mihaigalos/DotShine/hardware/DotShine.brd

## EAGLE design hardware/DotShine.brd (2019-03-06)

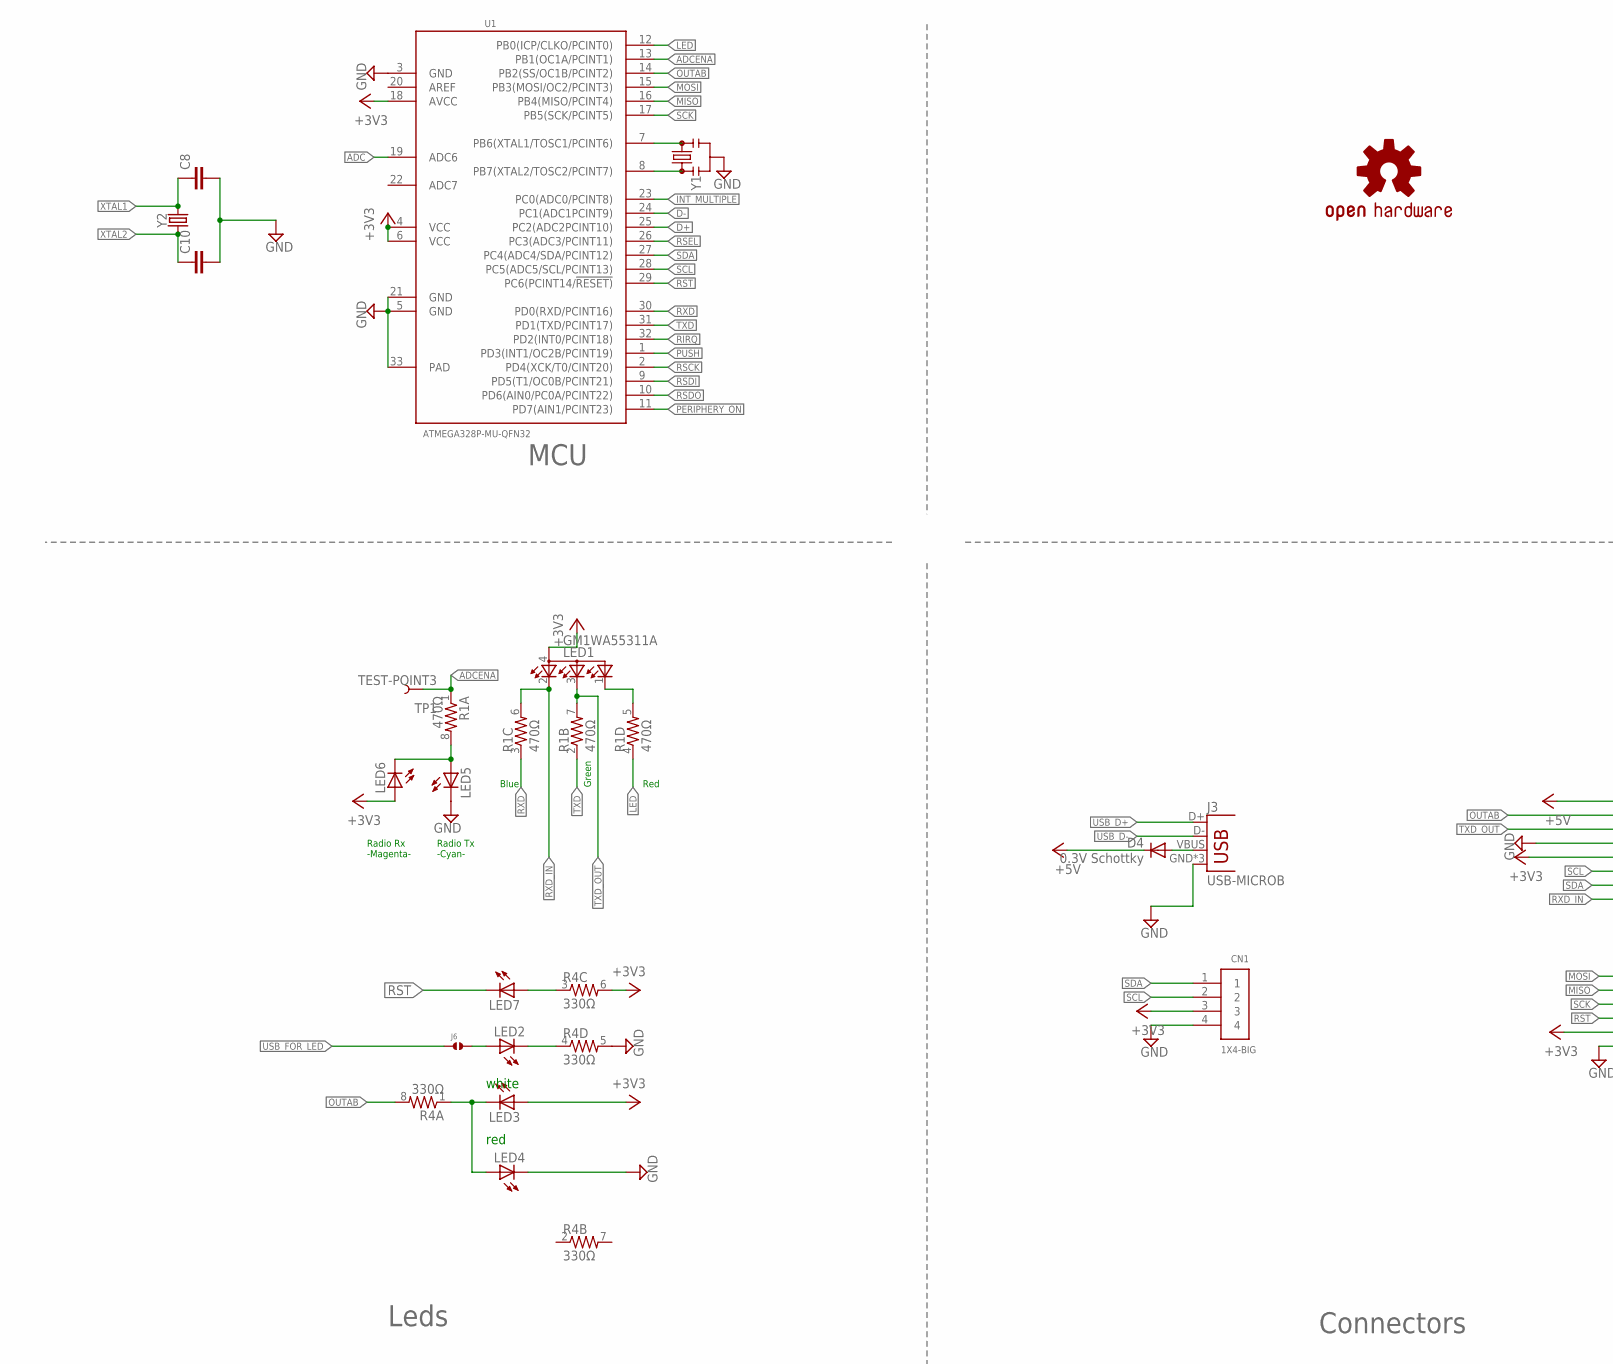
[picture p1: schematic DotShine.sch, part in row 1, column 1]

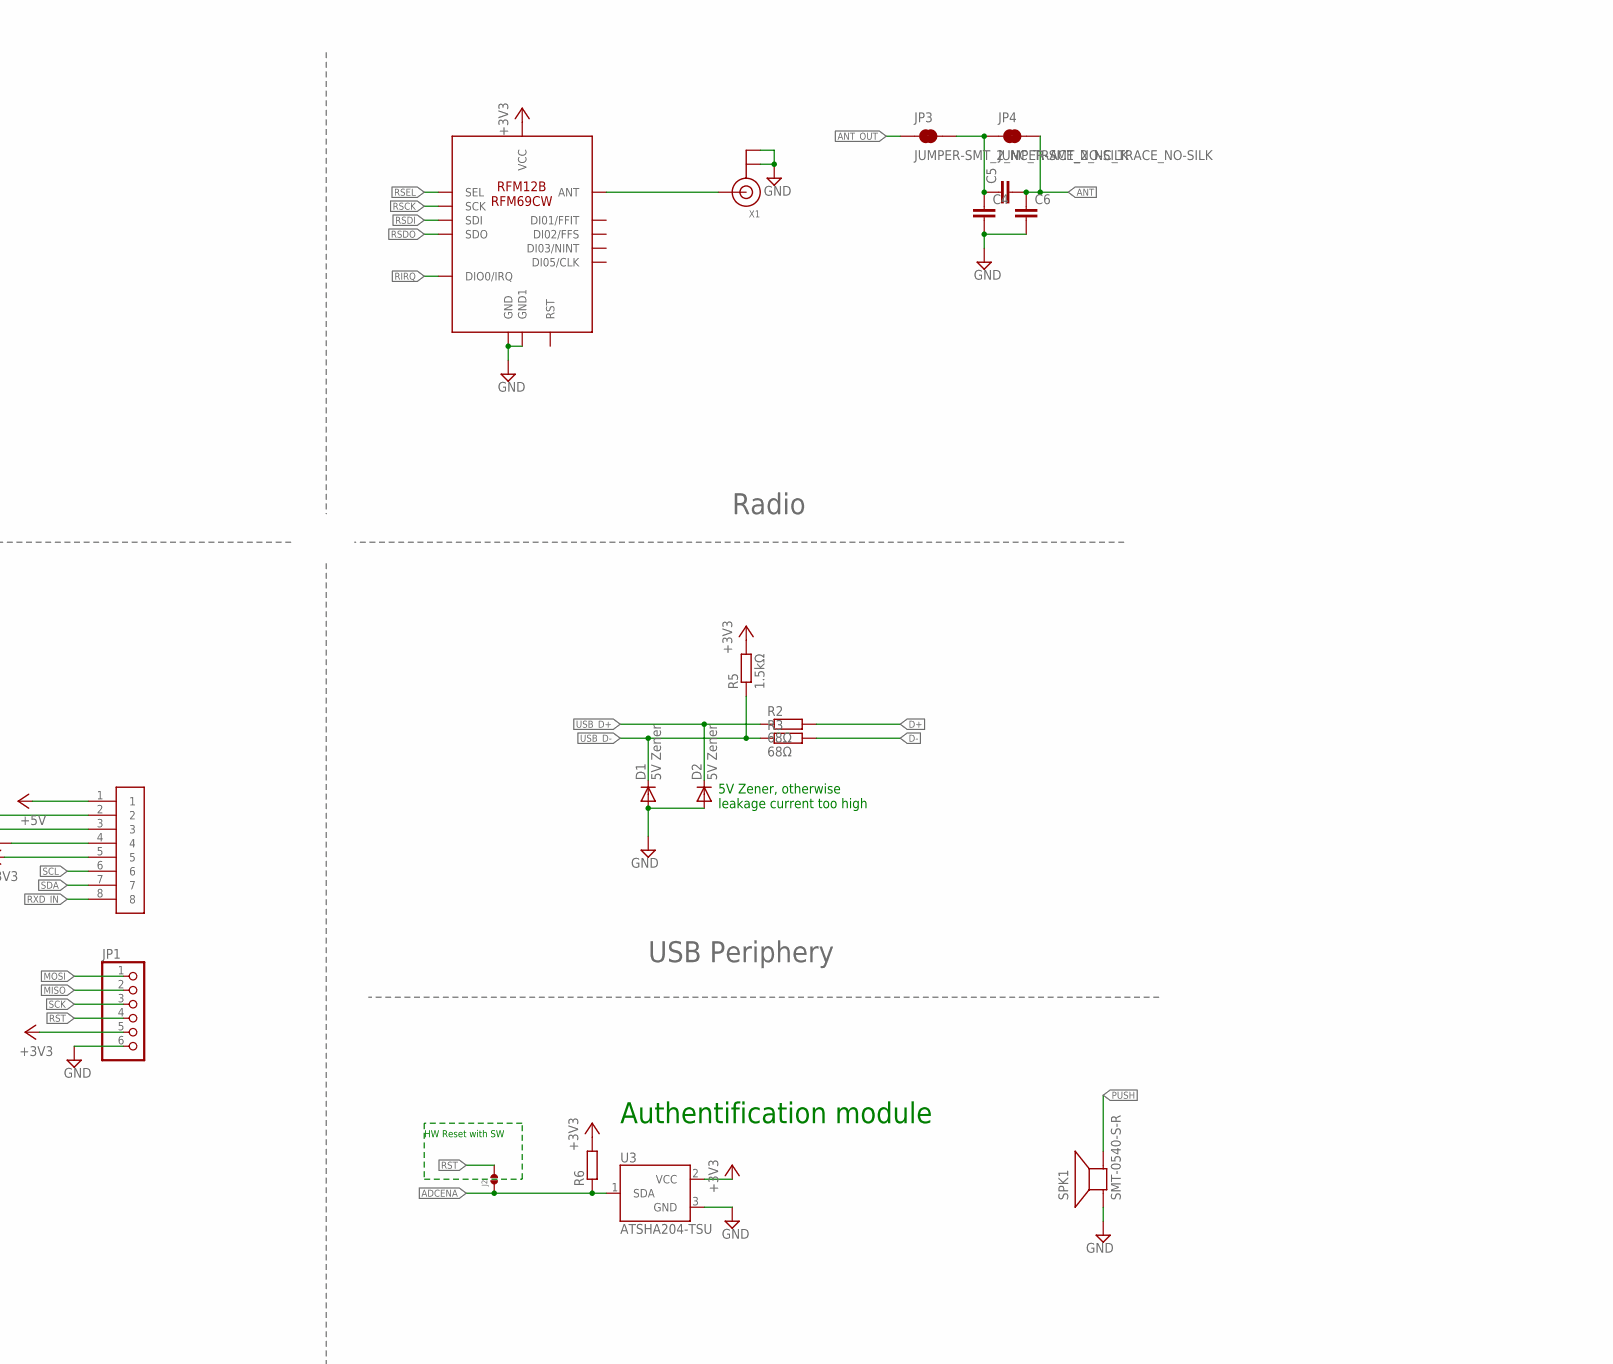
[picture p2: schematic DotShine.sch, part in row 1, column 2]

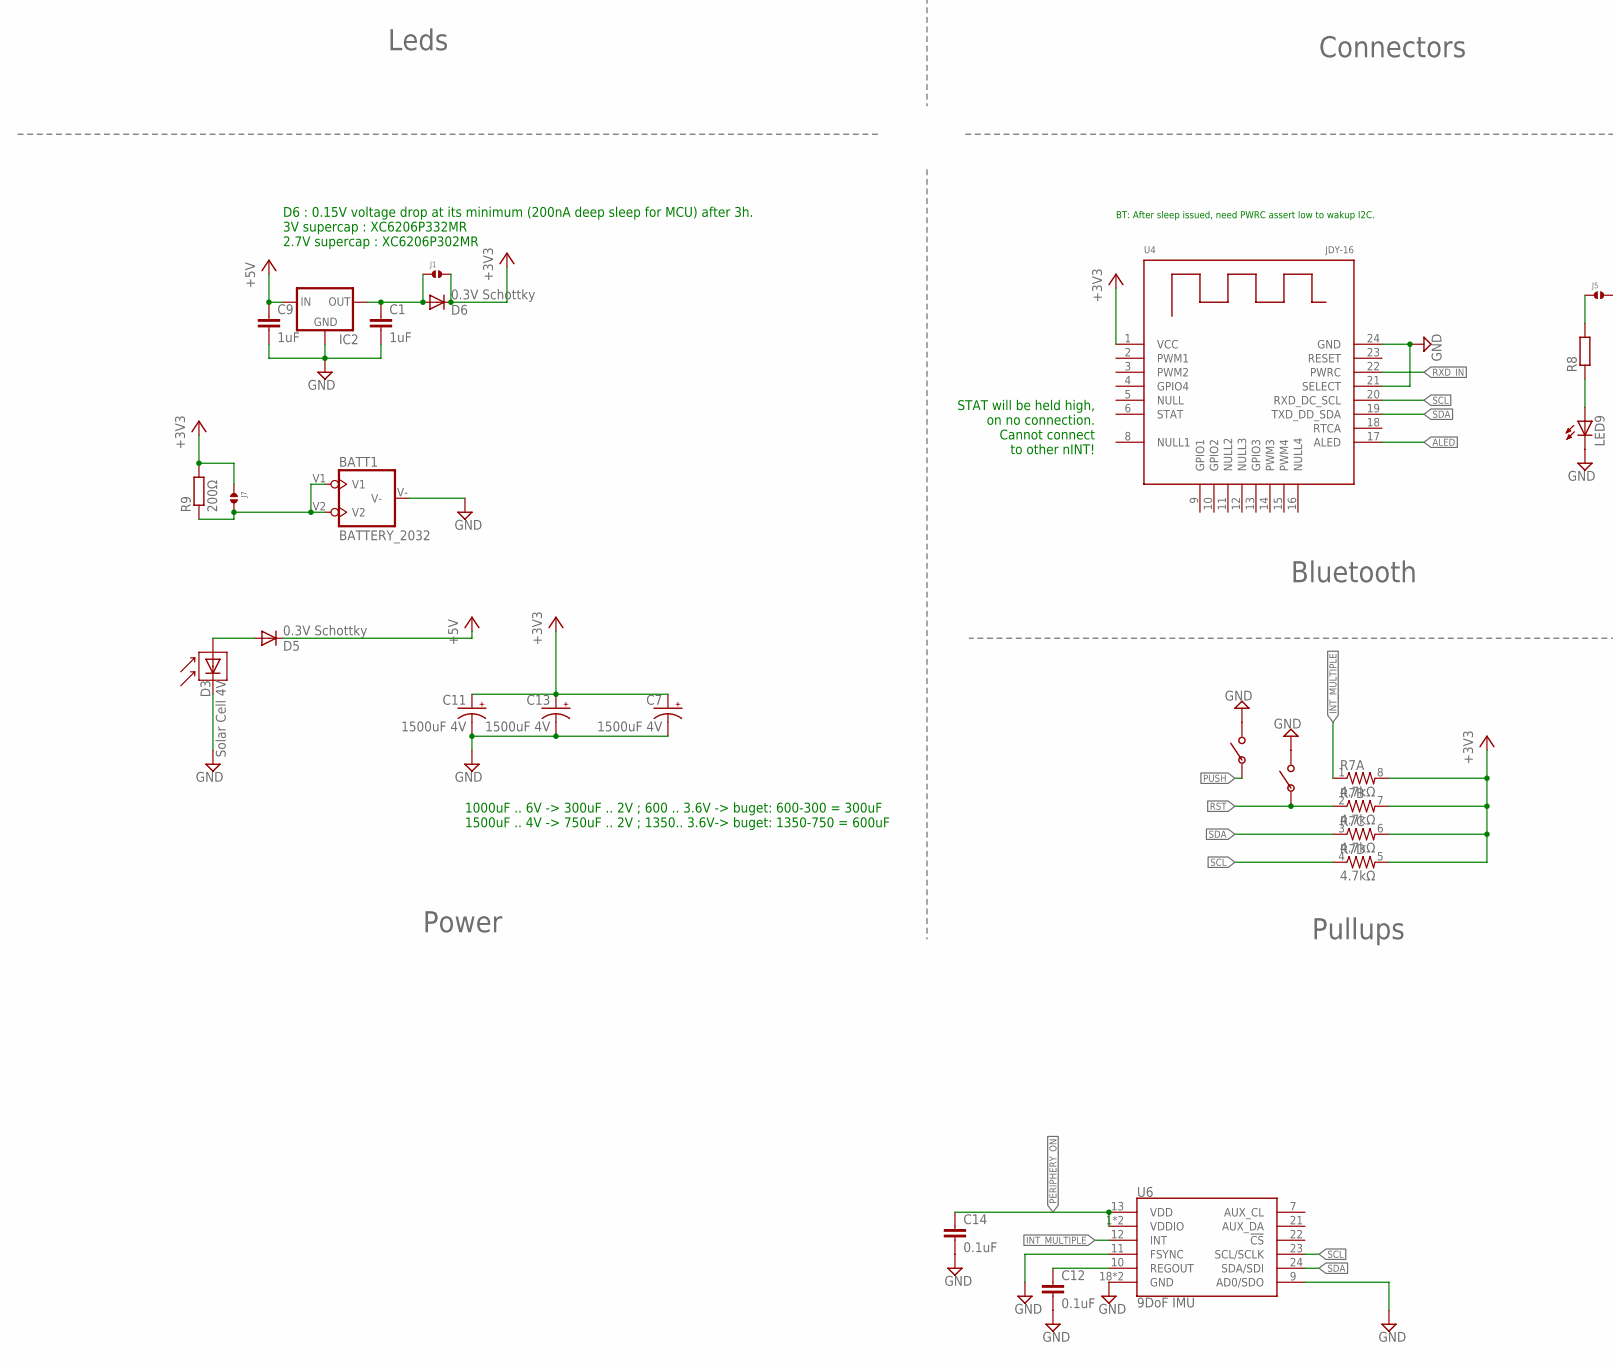
[picture p3: schematic DotShine.sch, part in row 2, column 1]

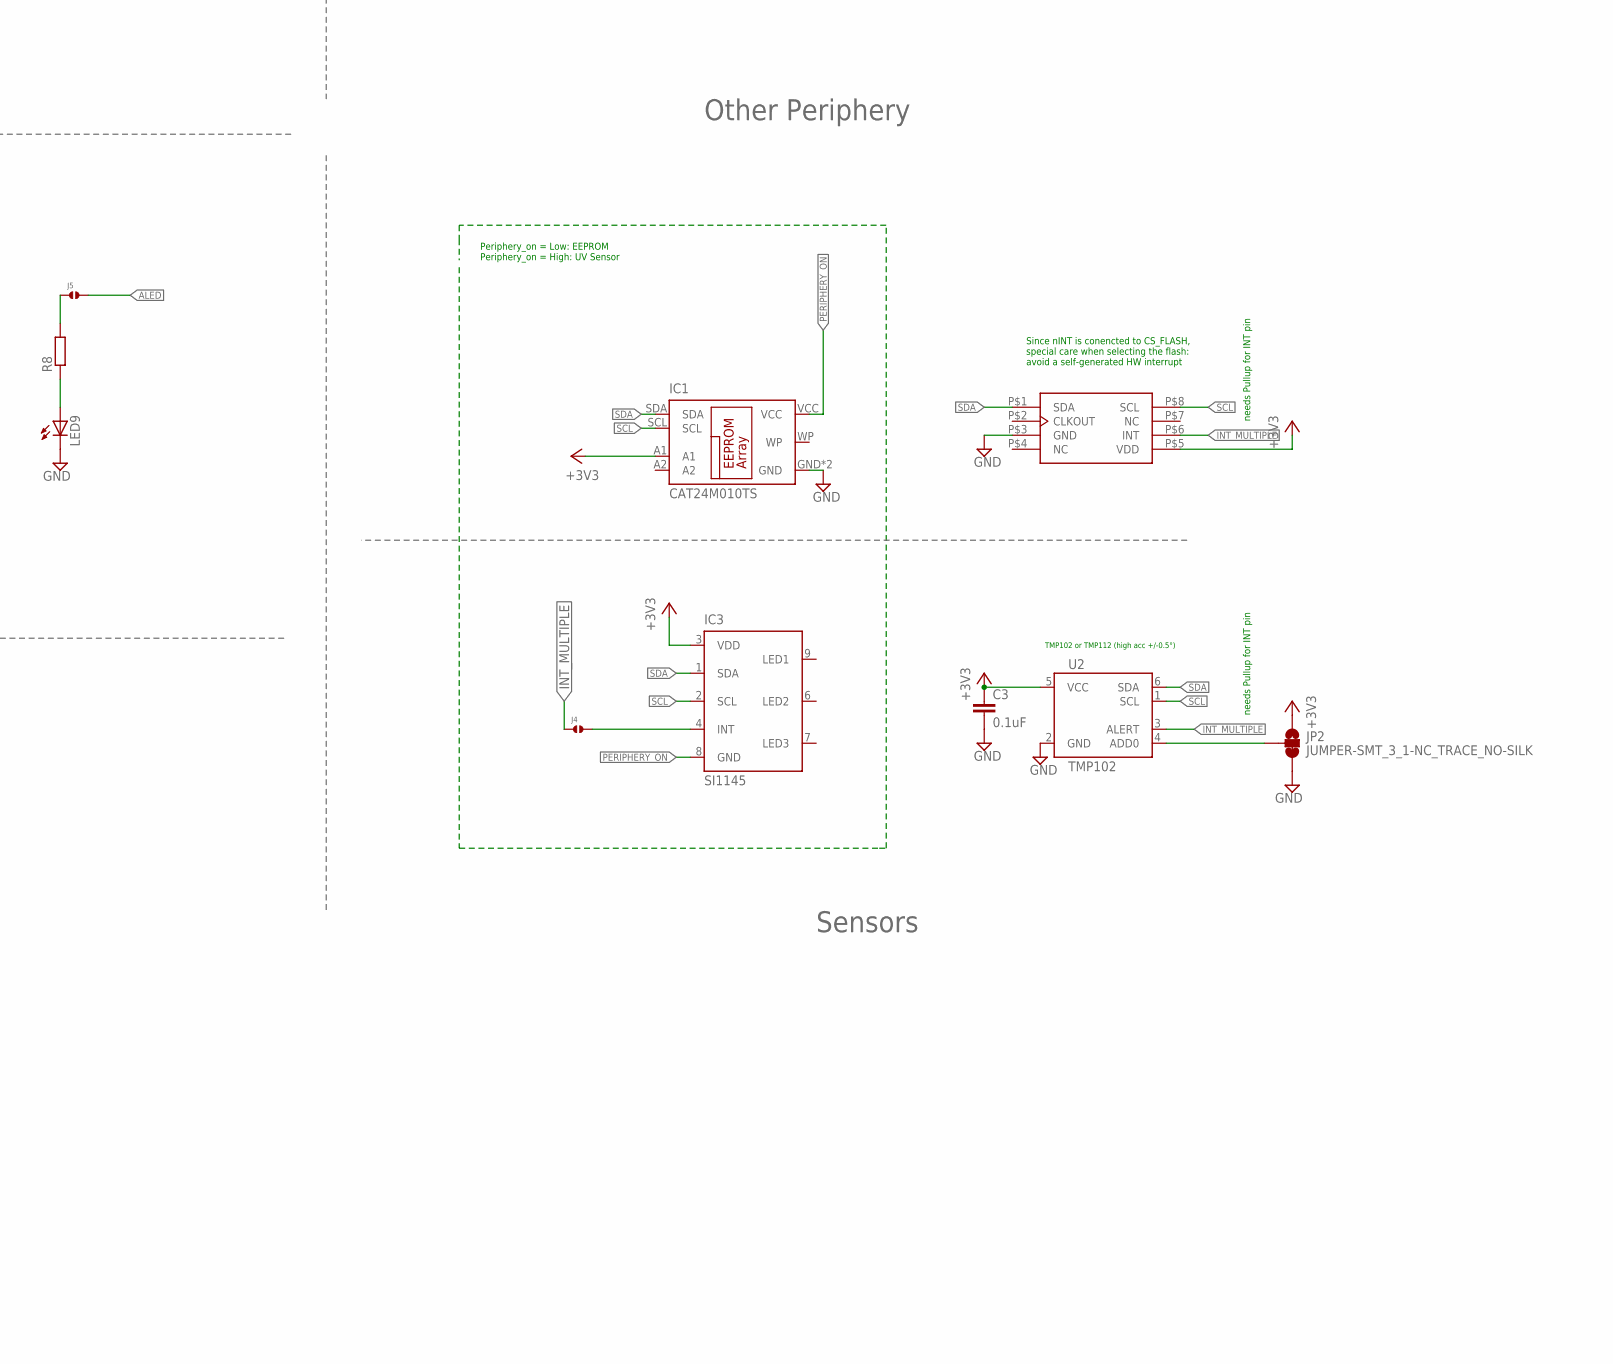
[picture p4: schematic DotShine.sch, part in row 2, column 2]

Parts:
BATT1: BATTERY_2032; BATT2032
C1, C9: 1uF; C0603
C3, C12, C14: 0.1uF; C0603
C4, C5, C6: C-EUC0603; C0603
C7, C11, C13: 1500uF 4V; CT7343
C8, C10: C-EUC0402; C0402
CN1: 1X4-BIG; 1X04-BIG
D1, D2: 5V Zener; SOD523
D3: Solar Cell 4V; SOLARBIT-12X1
D4, D5, D6: 0.3V Schottky; SOD523
IC1: CAT24M010TS; TSSOP8
IC2: MCP1700TT; SOT-23
IC3: SI1145; QFN-10
J1, J2, J4, J5, J6, J7: SOLDERJUMPER.2.MED; 2.MED
J3: USB-MICROB
JP1: PINHD-1X6; 1X06
JP2: JUMPER-SMT_3_1-NC_TRACE_NO-SILK; SMT-JUMPER_3_1-NC_TRACE_NO-SILK
JP3, JP4: JUMPER-SMT_2_NC_TRACE_NO-SILK; SMT-JUMPER_2_NC_TRACE_NO-SILK
LED1: GM1WA55311A
LED2, LED3, LED4, LED5, LED6, LED7, LED9: LED0603; LED-0603
LOGO1: OSHW-LOGOS; OSHW-LOGO-S
R1: 470Ω; 0603-ARV
R2, R3: 68Ω; R0603
R4: 330Ω; 0603-ARV
R5: 1.5kΩ; R0603
R6, R8: R-EU_R0603; R0603
R7: 4.7kΩ; 0603-ARV
R9: 200Ω; R0603
SPK1: SMT-0540-S-R
TP1: TEST-POINT3; PAD.03X.03
U1: ATMEGA328P-MU-QFN32; QFN32G-0.5-5X5MM
U2: TMP102; SOT563
U3: ATSHA204-TSU; SOT23-3
U4: JDY-16
U6: 9DoF IMU; QFN24-3X3
U$1: RFM12B/69CW
U$2, U$3: PUSHBUTTON_4X2.5
U$4: JST-8; S4B-ZR
X1: ANTENNA_U.FL; U.FL
X2: MC-RTC-RV-4162-C7-I2C; MC-RTC-C7
Y1: RESONATORSMD-3.2X1.3; RESONATOR-SMD-3.2X1.3
Y2: CRYSTALSMD-3.2X1.5; CRYSTAL-SMD-3.2X1.5MM

Connections:
+3V3: C3.1, C7.+, C11.+, C13.+, CN1.3, D6.C, IC1.A1, IC3.3 (VDD), J1.2, J7.1, JP1.5, JP2.1, LED1.4 (A), LED3.A, LED6.A, R4.6 (2), R5.2, R6.2, R7.5 (2), R7.6 (2), R7.7 (2), R7.8 (2), R9.2, U1.4 (VCC), U1.6 (VCC), U1.18 (AVCC), U2.5 (VCC), U3.2 (VCC), U4.1 (VCC), U$1.VDD (VCC), U$4.5, X2.P$5 (VDD)
+5V: C9.1, D4.C, D5.C, IC2.3 (IN), U$4.1
ADC: U1.19 (ADC6)
ADCENA: J2.1, R1.1, R6.1, TP1.P$1, U1.13 (PB1(OC1A/PCINT1)), U3.1 (SDA)
ALED: J5.2, U4.17 (ALED)
ANT: C5.2, C6.1, JP4.2
ANT_OUT: JP3.1, U$1.ANT, X1.3 (SIGNAL)
D+: R2.2, U1.25 (PC2(ADC2PCINT10))
D-: R3.2, U1.24 (PC1(ADC1PCINT9))
GND: BATT1.V-, C1.2, C3.2, C4.2, C6.2, C7.-, C8.2, C9.2, C10.2, C11.-, C12.2, C13.-, C14.2, CN1.4, D1.A, D2.A, D3.- (C), IC1.GND, IC1.NC (GND), IC2.1 (GND), J3.GND, J3.MT1 (GND), J3.MT2 (GND), JP1.6, JP2.3, LED4.C, LED5.C, LED9.C, R4.5 (2), SPK1.- (+), U1.3 (GND), U1.5 (GND), U1.21 (GND), U1.33 (PAD), U2.2 (GND), U3.3 (GND), U4.21 (SELECT), U4.24 (GND), U6.9 (AD0/SDO), U6.11 (FSYNC), U6.18 (GND), U6.20 (GND), U$1.GND, U$1.GND1, U$2.P$2, U$3.P$2, U$4.4, X1.1 (GND), X1.2 (GND), X2.P$3 (GND), Y1.2
INT_MULTIPLE: J4.1, R7.1, U1.23 (PC0(ADC0/PCINT8)), U2.3 (ALERT), U6.12 (INT), X2.P$6 (INT)
LED: R1.4 (1), U1.12 (PB0(ICP/CLKO/PCINT0))
MISO: JP1.2, U1.16 (PB4(MISO/PCINT4))
MOSI: JP1.1, U1.15 (PB3(MOSI/OC2/PCINT3))
unnamed: J5.1, R8.2
unnamed: C4.1, C5.1, JP3.2, JP4.1
unnamed: LED9.A, R8.1
unnamed: U1.7 (PB6(XTAL1/TOSC1/PCINT6)), Y1.3
unnamed: LED2.C, R4.4 (1)
unnamed: U1.8 (PB7(XTAL2/TOSC2/PCINT7)), Y1.1
unnamed: LED3.C, LED4.A, R4.1
unnamed: LED7.A, R4.3 (1)
unnamed: JP2.2, U2.4 (ADD0)
unnamed: LED5.A, LED6.C, R1.8 (2)
unnamed: LED1.1 (CGREEN), R1.5 (2)
unnamed: C1.1, D6.A, IC2.2 (OUT), J1.1
unnamed: IC3.4 (INT), J4.2
unnamed: J6.2, LED2.A
unnamed: BATT1.V1, BATT1.V2, J7.2, R9.1
unnamed: C12.1, U6.10 (REGOUT)
OUTAB: R4.8 (2), U1.14 (PB2(SS/OC1B/PCINT2)), U$4.2
PERIPHERY_ON: C14.1, IC1.VCC, IC3.8 (GND), U1.11 (PD7(AIN1/PCINT23)), U6.1 (VDDIO), U6.8 (VDDIO), U6.13 (VDD)
PUSH: SPK1.+ (-), U1.1 (PD3(INT1/OC2B/PCINT19)), U$3.P$1
RIRQ: U1.32 (PD2(INT0/PCINT18)), U$1.IRQ (DIO0/IRQ)
RSCK: U1.2 (PD4(XCK/T0/CINT20)), U$1.SCK
RSDI: U1.9 (PD5(T1/OC0B/PCINT21)), U$1.SDI
RSDO: U1.10 (PD6(AIN0/PC0A/PCINT22)), U$1.SDO
RSEL: U1.26 (PC3(ADC3/PCINT11)), U$1.SEL
RST: J2.2, JP1.4, LED7.C, R7.2 (1), U1.29 (PC6(PCINT14/!RESET)), U$2.P$1
RXD: R1.3 (1), U1.30 (PD0(RXD/PCINT16))
RXD_IN: LED1.2 (CRED), R1.6 (2), U4.22 (PWRC), U$4.8
SCK: JP1.3, U1.17 (PB5(SCK/PCINT5))
SCL: CN1.2, IC1.SCL, IC3.2 (SCL), R7.4 (1), U1.28 (PC5(ADC5/SCL/PCINT13)), U2.1 (SCL), U4.20 (RXD_DC_SCL), U6.23 (SCL/SCLK), U$4.6, X2.P$8 (SCL)
SDA: CN1.1, IC1.SDA, IC3.1 (SDA), R7.3 (1), U1.27 (PC4(ADC4/SDA/PCINT12)), U2.6 (SDA), U4.19 (TXD_DD_SDA), U6.24 (SDA/SDI), U$4.7, X2.P$1 (SDA)
SOLAR_OUT: D3.+ (A), D5.A
TXD: R1.2 (1), U1.31 (PD1(TXD/PCINT17))
TXD_OUT: LED1.3 (CBLUE), R1.7 (2), U$4.3
USB_D+: D2.C, J3.D+, R2.1
USB_D-: D1.C, J3.D-, R3.1, R5.1
USB_FOR_LED: D4.A, J3.VBUS, J6.1
XTAL1: C8.1, Y2.P$2 (2)
XTAL2: C10.1, Y2.P$1 (1)

Notes on the sheet:
MCU
Radio
Blue
Green
Red
TMP102 or TMP112 (high acc +/-0.5°)
Authentification module
white
red
Since nINT is conencted to CS_FLASH, special care when selecting the flash: avoid a self-generated HW interrupt
needs Pullup for INT pin
Radio Rx -Magenta-
Radio Tx -Cyan-
1000uF .. 6V -> 300uF .. 2V ; 600 .. 3.6V -> buget: 600-300 = 300uF 1500uF .. 4V -> 750uF .. 2V ; 1350.. 3.6V-> buget: 1350-750 = 600uF
D6 : 0.15V voltage drop at its minimum (200nA deep sleep for MCU) after 3h. 3V supercap : XC6206P332MR 2.7V supercap : XC6206P302MR
5V Zener, otherwise leakage current too high
HW Reset with SW
BT: After sleep issued, need PWRC assert low to wakup I2C.
Periphery_on = Low: EEPROM Periphery_on = High: UV Sensor
Leds
Connectors
USB Periphery
Other Periphery
Power
Bluetooth
Pullups
Sensors
STAT will be held high, on no connection. Cannot connect to other nINT!

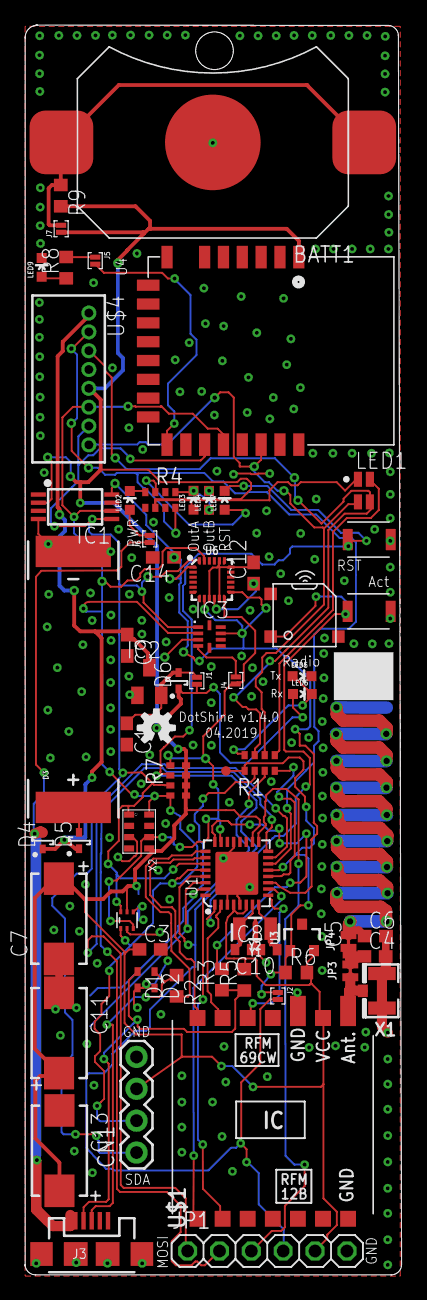
[picture p5: board DotShine.brd from above]

Board: 2 copper layers, 30.0 x 99.6 mm, 68 parts (1 on the bottom side), 51 nets.
