mihaigalos/DotShine/(commit log)

2018-06-29 Initial fork of hwrdware/ from DotPhat
    [DotPhat.brd, DotPhat.sch]
2018-07-01 Beta: initial arrange of solar
    [DotPhat.brd, DotPhat.sch]
2018-07-01 Reroute signals after repositioning
    [DotPhat.brd, DotPhat.sch]
2018-07-02 Add TP for TRx leds
    [DotPhat.brd, DotPhat.sch]
2018-07-02 Reposition components to accomodate possible LoRA RF
    [DotPhat.brd]
2018-07-02 Add FSK/LoRA silkscreen
    [DotPhat.brd]
2018-07-02 Add SJ for bypass threshold VCC, polarity markers
    [DotPhat.brd, DotPhat.sch]
2018-07-02 Move SDA & GND silkscreen left
    [DotPhat.brd]
2018-07-07 Move caps from parallel to series
    [DotPhat.brd, DotPhat.sch]
2018-07-07 Irrelevant since will be reverted
    [DotPhat.brd]
2018-07-07 Revert "Irrelevant since will be reverted"
    This reverts commit e891d672a37a9ace9540b21aee4dc257b77b94d6.
    [DotPhat.brd]
2018-07-07 Revert "Move caps from parallel to series"
    This reverts commit e29ebe1b9370ccceb9c5010c93145ac8bd52b422.
    [DotPhat.brd, DotPhat.sch]
2018-07-13 Reposition logos
    [DotPhat.brd]
2018-07-14 Add 3rd solar cap
    [DotPhat.brd, DotPhat.sch]
2018-07-14 Add capacity buget calculation
    [DotPhat.sch]
2018-07-14 Add mount hole
    [DotPhat.brd]
2018-07-14 Reposition Radio logo
    [DotPhat.brd]
2018-07-14 Correct diameter of fixation hole
    [DotPhat.brd]
2018-07-14 Refactor project name
    [DotShine.brd, DotShine.sch]
2018-07-15 Increase space for radio Id
    [DotShine.brd]
2018-07-20 Add schottky@LDO for solar powered operation
    [DotShine.brd, DotShine.sch]
2018-08-03 Add support for IXYS SLMD121H9L solar cell 45mA@4.5V
    [DotShine.brd]
2018-08-03 Account for panel of 62mm instead of 61mm
    [DotShine.brd]
2018-08-04 Add tip to solar + pad for easy soldering
    [DotShine.brd]
2018-08-04 Improve + pad
    [DotShine.brd]
2018-08-04 Account for datasheet irregularities: len 61 or 62mm
    [DotShine.brd]
2018-08-04 Remove soldermask @ solar gnd
    [DotShine.brd]
2018-08-04 move i2c eeprom connections further down
    [DotShine.brd]
2018-08-04 Add logo with correct pointer to DotShine
    [DotShine.brd]
2018-08-04 Adjust bstop around +
    [DotShine.brd]
2018-08-04 Add second zener if using large solar panel
    [DotShine.brd, DotShine.sch]
2018-08-04 Add second strong zener if using large solar panel
    [DotShine.brd, DotShine.sch]
2018-08-04 Correct unrouted traces
    [DotShine.brd]
2018-08-04 Connect + of solar together, share Schottky
    [DotShine.brd, DotShine.sch]
2018-08-10 On Led -> USB, now at 5V. Only on when usb present
    [DotShine.brd, DotShine.sch]
2018-08-12 Rem superfluous Zener for solar, out it to LDO
    [DotShine.brd, DotShine.sch]
2018-08-14 Separate USB Led from solar
    [DotShine.brd, DotShine.sch]
2018-08-14 Move leftmost schottky left, overlap with stencil
    [DotShine.brd]
2018-08-14 Realign leftmost schottky
    [DotShine.brd]
2018-08-14 Add Schottky simbol to leftmost diode
    [DotShine.brd]
2018-08-15 Improve usb power lines width
    [DotShine.brd]
2018-08-19 Remove IXYS SLMD121H9L solar cell 45mA@4.5V, use small cell and i2c micro crystal
    [DotShine.brd, DotShine.sch]
2018-08-19 Add RST led
    [DotShine.brd, DotShine.sch]
2018-08-20 Add OG tag
    [DotShine.brd]
2018-08-22 Invert cap, improve GND
    [DotShine.brd, DotShine.sch]
2018-09-19 Refactor Caps from 5V to 3.3V, update version
    [DotShine.brd, DotShine.sch]
2018-09-19 Add SJ for ADCENA and RST -> HW reset through SW
    [DotShine.brd, DotShine.sch]
2018-09-20 Increase tracewidth near LDO
    [DotShine.brd]
2018-09-20 Remove superfluous text
    [DotShine.brd]
2018-09-20 Improve tracewidth near LDO
    [DotShine.brd]
2018-09-27 Add UV Sensor INT to cabled OR
    [DotShine.brd, DotShine.sch]
2018-09-27 UV power controlled from MCU (no sleep), TXD to JST
    [DotShine.brd, DotShine.sch]
2018-10-07 Update LDO description
    [DotShine.sch]
2018-10-07 Initial version with BLE using JDY-16
    [DotShine.brd, DotShine.sch]
2018-10-10 Initial bluetooth integration
    [DotShine.brd, DotShine.sch]
2018-10-11 Add and flip JST8, add BLE logo
    [DotShine.brd]
2018-10-16 Flip BT logo
    [DotShine.brd]
2018-10-29 Flip bluetooth logo
    [DotShine.brd]
2018-10-29 Revert "Flip bluetooth logo"
    This reverts commit 86c453a6030c35620ff411ae46af383bfef934ec.
    [DotShine.brd]
2018-10-29 Mirror bluetooth logo to tBottom
    [DotShine.brd]
2018-10-31 Add PWRC connection for BT, needed to assert low to reenable I2C
    [DotShine.brd, DotShine.sch]
2018-11-01 Connect BT Stat to INT_MULTIPLE, SJ on ALED
    [DotShine.brd, DotShine.sch]
2018-11-01 Reduce warnings
    [DotShine.brd]
2018-11-02 Increase version
    [DotShine.brd]
2018-11-03 SJ on PWR led
    [DotShine.brd, DotShine.sch]
2018-11-27 Connect E2PROM A1 to 3V3, avoid collision with BLE
    [DotShine.brd, DotShine.sch]
2018-11-27 Fix board schematic inconsistency
    [DotShine.brd, DotShine.sch]
2018-11-27 Remove BLE RGB
    [DotShine.brd, DotShine.sch]
2018-11-30 Update Ext fuse for 1.8V brown-out
2018-12-03 Improve GND
    [DotShine.brd]
2018-12-03 I2C EEPROM Vdd controlled from MCU pin
    [DotShine.brd, DotShine.sch]
2018-12-03 Improve naming
    [DotShine.brd, DotShine.sch]
2018-12-03 Add reminder to measure minimize E2PROM current from MCU pin
    [DotShine.brd]
2018-12-06 Add coincell
    [DotShine.brd, DotShine.sch]
2018-12-07 Approve superfluous
    [DotShine.brd]
2018-12-09 Tristate Periphery_On
    [DotShine.brd, DotShine.sch]
2018-12-09 Restructure schematic in groups
    [DotShine.sch]
2018-12-09 Improve restructuring
    [DotShine.sch]
2018-12-11 Add second solar cell, consolidate GND
    [DotShine.brd, DotShine.sch]
2018-12-11 Realign vertical drills
    [DotShine.brd]
2018-12-11 Add supercap logo
    [DotShine.brd]
2018-12-11 Remove Supercap logo
    [DotShine.brd]
2018-12-11 Reposition PWR logo
    [DotShine.brd]
2018-12-11 Reposition GND via in center of CR2032
    [DotShine.brd]
2018-12-11 Reposition FSK/LoRA logos
    [DotShine.brd]
2018-12-15 Add current limiter for coincell
    [DotShine.brd, DotShine.sch]
2018-12-17 Add value for current limit for coincell
    [DotShine.brd, DotShine.sch]
2018-12-20 Add 9DoF MPU9250, increase version
    [DotShine.brd, DotShine.sch]
2019-01-20 Add missing 3V3 for OutA, RGB
    [DotShine.brd]
2019-02-12 Update brown-out & fuses for 2Mhz operation @ 1.8V
2019-03-06 Add pullup to INT_MULTIPLE
    [DotShine.brd, DotShine.sch]
2019-03-06 Optimize to 99mm for cost
    [DotShine.brd, DotShine.sch]
2019-03-06 Increase version, optimize GND
    [DotShine.brd]
2019-03-06 Optimize GND
    [DotShine.brd]
2019-03-06 Approve irrelevant warnings
    [DotShine.brd]
